norisionut12/12V-Class-AB-Audio-Amplifier/Images/final.png

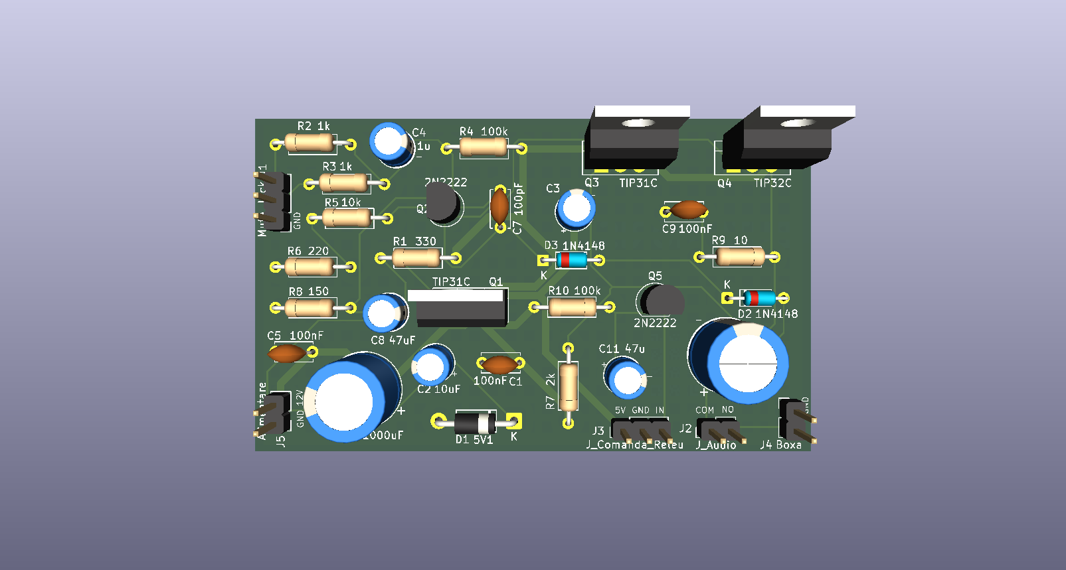
Images/final.png
