norisionut12/12V-Class-AB-Audio-Amplifier/KiCad_Design_Files/final.kicad_pcb

## KiCad design KiCad_Design_Files/final.kicad_pcb (2026-10-15)

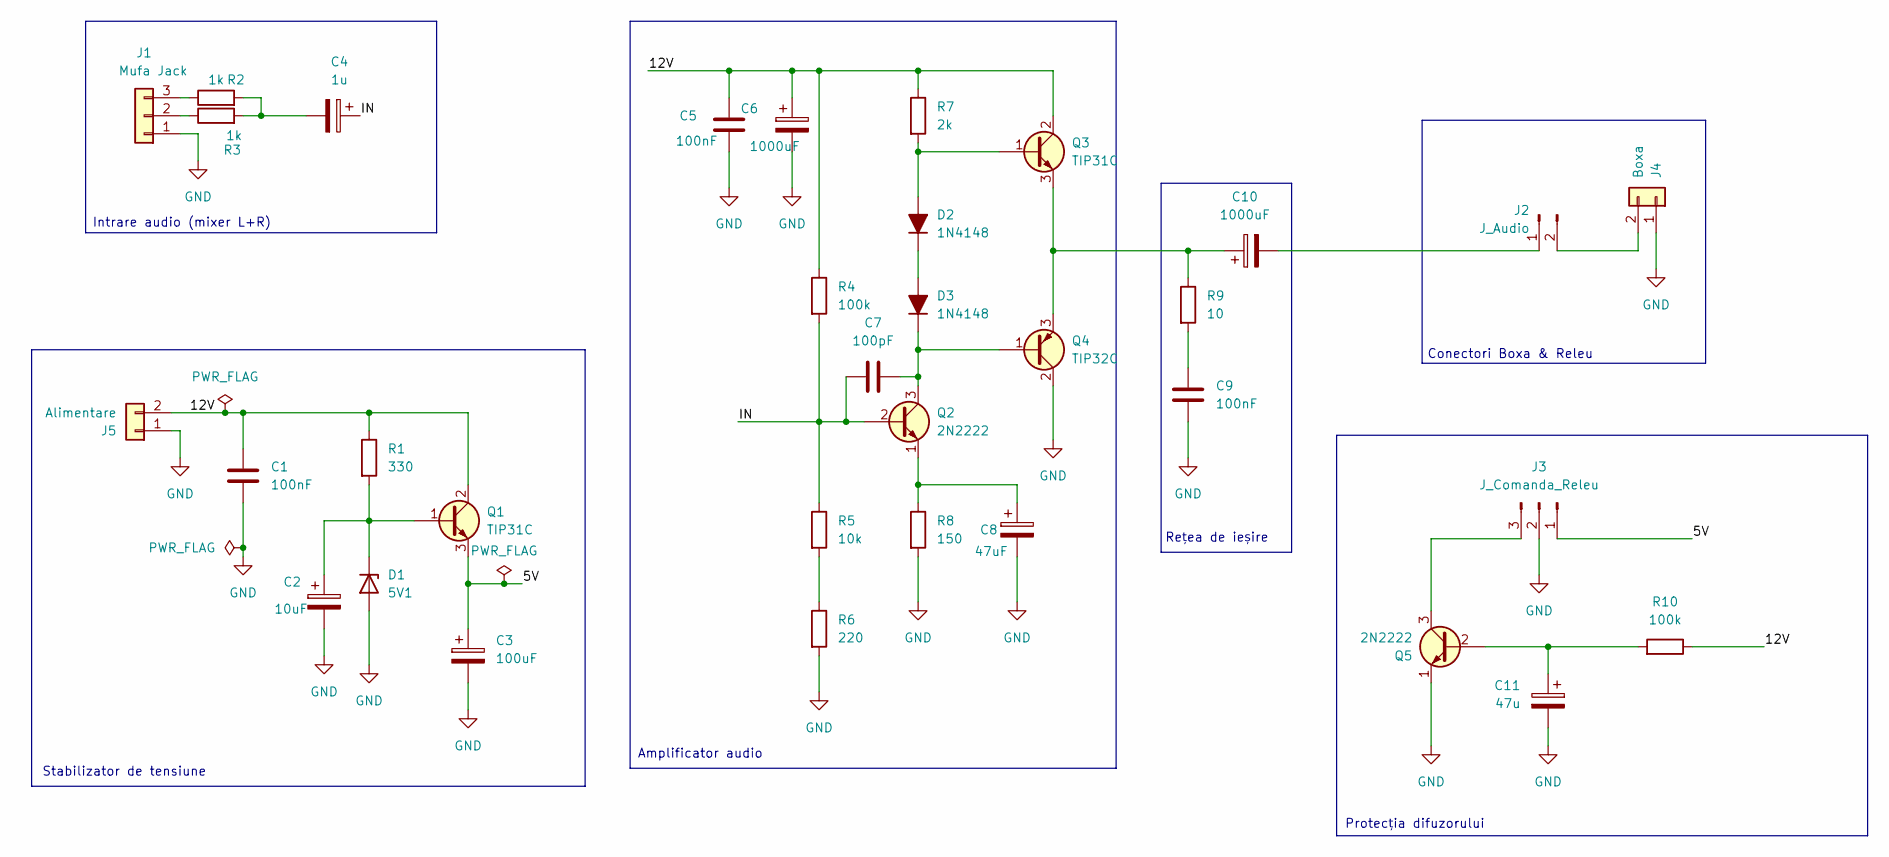
[picture p22: schematic final.kicad_sch, Amplificator audio în clasă AB cu alimentare de 12 V]

Parts:
C1, C5, C9: 100nF; C_Disc_D5.0mm_W2.5mm_P5.00mm
C2: 10uF; CP_Radial_D5.0mm_P2.00mm
C3: 100uF; CP_Radial_D5.0mm_P2.00mm
C4: 1u; CP_Radial_D5.0mm_P2.00mm
C6, C10: 1000uF; CP_Radial_D10.0mm_P5.00mm
C7: 100pF; C_Disc_D5.0mm_W2.5mm_P5.00mm
C8: 47uF; CP_Radial_D5.0mm_P2.00mm
C11: 47u; CP_Radial_D5.0mm_P2.00mm
D1: 5V1; D_DO-41_SOD81_P10.16mm_Horizontal
D2, D3: 1N4148; D_DO-35_SOD27_P7.62mm_Horizontal
J1: Mufa Jack; PinHeader_1x03_P2.54mm_Vertical
J2: J_Audio; PinHeader_1x02_P2.54mm_Vertical
J3: J_Comanda_Releu; PinHeader_1x03_P2.54mm_Vertical
J4: Boxa; PinHeader_1x02_P2.54mm_Vertical
J5: Alimentare; PinHeader_1x02_P2.54mm_Vertical
Q1, Q3: TIP31C; TO-220-3_Vertical
Q2, Q5: 2N2222; TO-92_Inline
Q4: TIP32C; TO-220-3_Vertical
R1: 330; R_Axial_DIN0207_L6.3mm_D2.5mm_P10.16mm_Horizontal
R2, R3: 1k; R_Axial_DIN0207_L6.3mm_D2.5mm_P10.16mm_Horizontal
R4, R10: 100k; R_Axial_DIN0207_L6.3mm_D2.5mm_P10.16mm_Horizontal
R5: 10k; R_Axial_DIN0207_L6.3mm_D2.5mm_P10.16mm_Horizontal
R6: 220; R_Axial_DIN0207_L6.3mm_D2.5mm_P10.16mm_Horizontal
R7: 2k; R_Axial_DIN0207_L6.3mm_D2.5mm_P10.16mm_Horizontal
R8: 150; R_Axial_DIN0207_L6.3mm_D2.5mm_P10.16mm_Horizontal
R9: 10; R_Axial_DIN0207_L6.3mm_D2.5mm_P10.16mm_Horizontal

Connections:
/5V: C3.1, J3.1, Q1.3 (E)
/12V: C1.1, C5.1, C6.1, J5.2, Q1.2 (C), Q3.2 (C), R1.1, R4.1, R7.1, R10.1
GND: C1.2, C2.2, C3.2, C5.2, C6.2, C8.2, C9.2, C11.2, D1.2 (A), J1.1, J3.2, J4.1, J5.1, Q4.2 (C), Q5.1 (E), R6.2, R8.2
unnamed: C4.2, R2.2, R3.2
unnamed: C9.1, R9.2
unnamed: C2.1, D1.1 (K), Q1.1 (B), R1.2
unnamed: D2.2 (A), Q3.1 (B), R7.2
unnamed: D2.1 (K), D3.2 (A)
unnamed: C7.2, D3.1 (K), Q2.3 (C), Q4.1 (B)
unnamed: J1.2, R3.1
unnamed: J1.3, R2.1
unnamed: C10.2, J2.1
unnamed: J2.2, J4.2
unnamed: J3.3, Q5.3 (C)
unnamed: C4.1, C7.1, Q2.2 (B), R4.2, R5.1
unnamed: C8.1, Q2.1 (E), R8.1
unnamed: C10.1, Q3.3 (E), Q4.3 (E), R9.1
unnamed: C11.1, Q5.2 (B), R10.2
unnamed: R5.2, R6.1

Notes on the sheet:
Stabilizator de tensiune
Protecția difuzorului
Conectori Boxa & Releu
Amplificator audio
Intrare audio (mixer L+R)
Rețea de ieșire

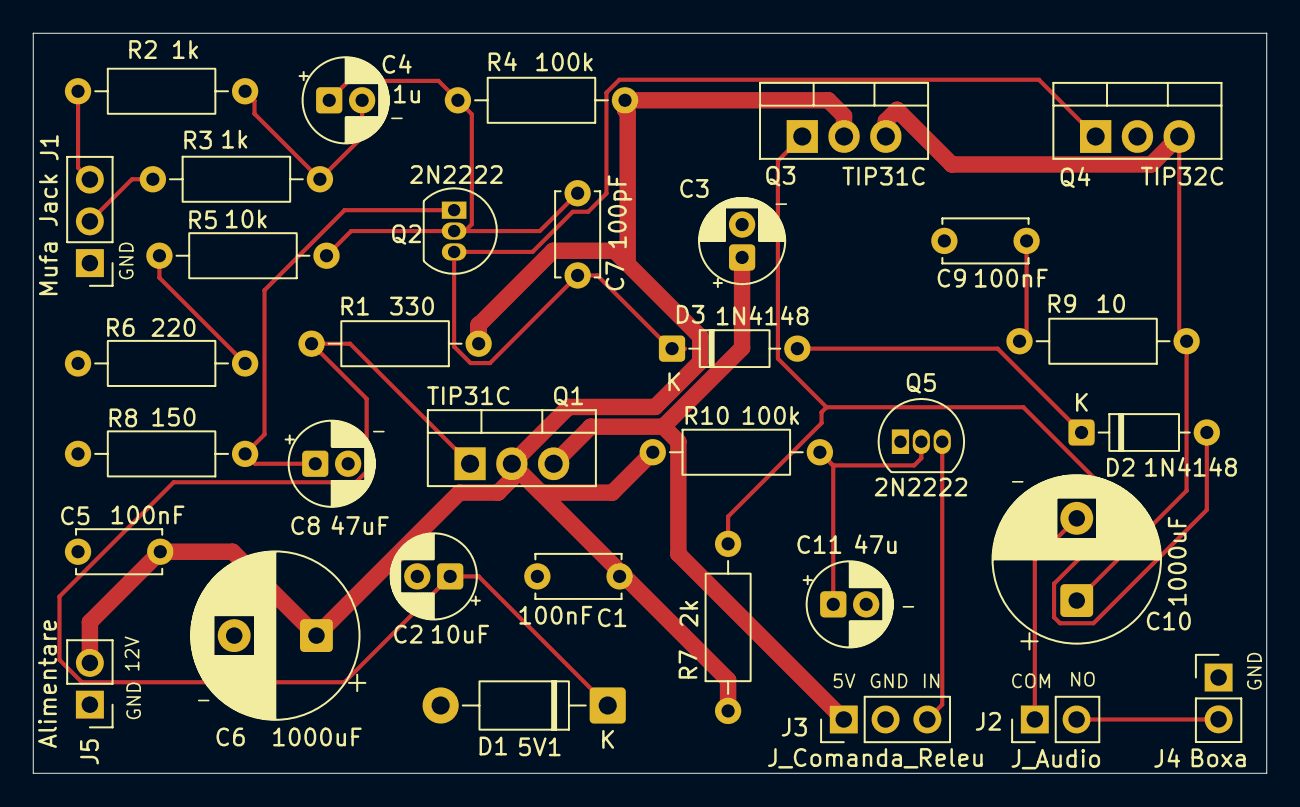
[picture p23: board final.kicad_pcb from above]

Board: 2 copper layers, 75.0 x 45.0 mm, 34 parts (0 on the bottom side), 19 nets.
